GildardoRestrepo/greenhouse_Mata_freeRTOS/docs/arquitectura.md

---
type: arquitectura
created: 2026-11-08
estado: borrador — fuente de verdad del diseño de software
---
# Arquitectura de software — Mata

> [!resumen]
> 5 tareas de aplicación (CMSIS-RTOS v2 sobre FreeRTOS), 5 niveles de prioridad. La tarea **Control** es la única dueña de la máquina de estados y recibe *todo* por una sola cola de eventos. **Actuadores** recibe órdenes por notificación de tarea y corta la bomba por su cuenta aunque Control falle. El bus I²C se protege con un mutex; la UART tiene un único dueño (Logger), así que no lo necesita.

> [!nota] Bomba simulada (2026-11-10)
> Por presupuesto no hay bomba real: en **PC6 va un LED indicador** (con 220 Ω) que ocupa su lugar. En este documento "bomba" significa ese LED. El software no cambia: mismos nombres (`CMD_PUMP_PULSE`, `PUMP_PULSE_MS`, `EV_PUMP_DONE`), mismo pin y mismo pulso con tiempo máximo. El sensor de suelo es el resistivo **YL-69 + YL-38** (salida AO). Ver [[bom]].

---

## 1. Diagrama de bloques

```mermaid
flowchart LR
  subgraph Entradas
    SOIL[Sensor suelo YL-69<br/>ADC PC0]
    LDR[LDR<br/>ADC PC1]
    AHT[HTU21<br/>I2C1 0x40]
    BTN[K0 / K1 / K_UP<br/>EXTI]
  end
  subgraph STM32F407 + FreeRTOS
    SEN[tSensors]
    CTL[tControl]
    ACT[tActuators]
    DSP[tDisplay]
    LOG[tLogger]
  end
  subgraph Salidas
    PUMP[LED de riego<br/>PC6, bomba simulada]
    RGB[LED RGB<br/>TIM4 PWM]
    BUZ[Buzzer<br/>PC7 activo en alto]
    OLED[OLED<br/>I2C1]
    UART[USART1 → PC]
  end
  SOIL --> SEN
  LDR --> SEN
  AHT --> SEN
  BTN -- ISR --> CTL
  SEN -- qEvents --> CTL
  CTL -- notificación --> ACT
  ACT -- qEvents --> CTL
  ACT --> PUMP & RGB & BUZ
  DSP --> OLED
  CTL -. snapshot + mtxData .-> DSP
  CTL -- qLog --> LOG
  LOG --> UART
```

---

## 2. Tareas

| Tarea | Responsabilidad | Prioridad (CMSIS) | Activación | Pila (palabras) | Recursos compartidos |
|---|---|---|---|---|---|
| `tActuators` | Encender/apagar bomba con **tiempo máximo**; patrones de buzzer; color del LED RGB según estado | `osPriorityHigh` | Evento: notificación desde `tControl`. Timeout de la espera = fin del pulso de riego | 256 | GPIO PC6/PC7, TIM4 (solo ella) |
| `tControl` | Máquina de estados, umbrales con histéresis, detección de errores, decide riego | `osPriorityAboveNormal` | Evento: `qEvents` (lecturas, botones, fin de riego). Timeout 1 s para detectar sensores mudos | 256 | escribe `g_snapshot` (mtxData) |
| `tSensors` | Leer ADC (suelo, LDR) con promedio, leer HTU21 (con CRC), validar rangos | `osPriorityNormal` | Periódica **500 ms** (`osDelayUntil`); HTU21 cada 4 ciclos (2 s) | 256 | I2C1 (mtxI2C) |
| `tDisplay` | Dibujar pantallas en la OLED | `osPriorityBelowNormal` | Periódica **250 ms** | 384 | I2C1 (mtxI2C), lee `g_snapshot` (mtxData) |
| `tLogger` | Único escritor de la UART: mensajes y telemetría | `osPriorityLow` | Evento: `qLog` | 384 | USART1 (exclusiva) |

**5 niveles distintos** (High > AboveNormal > Normal > BelowNormal > Low); el mínimo exigido es 3.

### Justificación de prioridades (urgencia ↔ consecuencia de llegar tarde)
- **tActuators — la más alta.** Con una bomba real, apagar tarde inunda la matera; el LED de riego la representa y se mantiene la misma exigencia de tiempo. Su trabajo es corto (cambiar un pin), así que no roba CPU. Además corta la bomba por *timeout propio*: aunque Control se cuelgue, la bomba no queda encendida.
- **tControl — alta.** Debe reaccionar a botones y a lecturas en < 50 ms para que la interfaz se sienta inmediata y para mandar el apagado a tiempo. Trabajo acotado (una transición por evento).
- **tSensors — media.** La humedad del suelo cambia en minutos; un retraso de decenas de ms es irrelevante, pero el periodo debe ser estable para promediar bien.
- **tDisplay — baja.** Solo estética; si refresca 100 ms tarde nadie lo nota. Es la tarea más larga (≈25 ms de I²C por cuadro), por eso no debe bloquear a las demás.
- **tLogger — la más baja.** La telemetría puede salir tarde sin consecuencias; la cola absorbe ráfagas.

### Verificación de pila
- `configCHECK_FOR_STACK_OVERFLOW = 2` + `vApplicationStackOverflowHook()` → `act_fatal_stack_overflow()`: bomba y buzzer apagados, LED rojo fijo y el sistema se detiene (sin mensaje: en ese punto la UART ya no es confiable).
- Cada tarea reporta `uxTaskGetStackHighWaterMark(NULL)` al logger cada 10 s (comando o modo debug). Criterio: **≥ 25 % libre** después de la prueba de 5 min. Documentar los valores medidos en la tabla final.
- Regla: nada de buffers grandes en pila (framebuffer OLED de 1 KB es `static` global).

---

## 3. Comunicación y sincronización

| Objeto | Tipo | Productores → Consumidor | Dato | Por qué este mecanismo |
|---|---|---|---|---|
| `qEvents` | Cola, 8 × `app_event_t` | tSensors, tActuators, ISR botones → **tControl** | lectura nueva, botón, fin de riego, fallo | Varios productores, un consumidor; serializa todo lo que cambia el estado → la máquina de estados no necesita locks. ISR-safe (`osMessageQueuePut` con timeout 0). |
| notificación de `tActuators` | Thread flags de CMSIS-RTOS v2 (= task notification de FreeRTOS; un bit por comando) | **tControl** → tActuators | `CMD_PUMP_PULSE`, `CMD_PUMP_STOP`, `CMD_BEEP`, `CMD_LED_STATE` | Un solo consumidor conocido; más rápida y liviana que una cola. El timeout de la espera sirve como temporizador del pulso. |
| `qLog` | Cola, 16 × `log_msg_t` (64 B) | todas → **tLogger** | texto con timestamp | Desacopla: nadie se bloquea esperando la UART. |
| `mtxI2C` | Mutex (herencia de prioridad) | tSensors, tDisplay | acceso al bus I2C1 | Dos tareas usan el mismo bus; una transacción a medias corrompe ambas. Mutex (no semáforo) por la herencia de prioridad. |
| `mtxData` | Mutex | tControl (escribe), tDisplay y tLogger (leen) | `g_snapshot` (estado + últimas lecturas) | Estructura de varios campos: sin protección la pantalla podría mostrar mezcla de lecturas viejas y nuevas. |
| sem. DMA UART | Notificación desde `HAL_UART_TxCpltCallback` | ISR → tLogger | fin de transmisión | El logger se **bloquea** mientras el DMA envía (no hay espera activa). |

```mermaid
sequenceDiagram
  participant ISR as ISR EXTI
  participant SEN as tSensors (Normal)
  participant CTL as tControl (AboveNormal)
  participant ACT as tActuators (High)
  participant LOG as tLogger (Low)
  SEN->>CTL: qEvents: EV_READING (suelo 12 %)
  CTL->>ACT: notify CMD_PUMP_PULSE
  CTL->>LOG: qLog "MONITOREO→RIEGO"
  Note over ACT: bomba ON, espera notificación<br/>con timeout 1 s
  ACT->>CTL: qEvents: EV_PUMP_DONE (timeout)
  ISR->>CTL: qEvents: EV_BTN_K1 (manual)
```

### Tipos compartidos (`App/Inc/app_types.h`)
```c
typedef enum { ST_INIT, ST_MONITOR, ST_IRRIGATE, ST_MANUAL, ST_ALARM } sys_state_t;

typedef enum {
  EV_READING, EV_SENSOR_FAULT, EV_PUMP_DONE,
  EV_BTN_K0, EV_BTN_K1, EV_BTN_KUP, EV_BTN_KUP_LONG
} event_type_t;

typedef struct {
  int16_t  soil_pct;      /* 0..100, -1 = inválido */
  int16_t  light_pct;     /* 0..100 */
  int16_t  temp_cC;       /* centésimas de °C (evita printf de float) */
  int16_t  hum_cPct;      /* centésimas de %HR */
  uint8_t  valid_mask;    /* bit0 suelo, bit1 luz, bit2 aire */
} readings_t;

typedef struct {
  event_type_t type;
  uint32_t     tick;      /* osKernelGetTickCount() al crear el evento */
  union { readings_t r; uint8_t fault_code; } data;
} app_event_t;

/* Causa de un fallo: en EV_SENSOR_FAULT y en el snapshot (la OLED la muestra). */
typedef enum {
  FAULT_NONE, FAULT_SOIL, FAULT_AIR, FAULT_ADC,       /* los genera tSensors */
  FAULT_TIMEOUT, FAULT_NO_WATER, FAULT_OVERTEMP       /* los decide tControl */
} fault_code_t;

/* g_snapshot: lo escribe tControl (shared_set), lo leen tDisplay y tLogger (shared_get). */
typedef struct {
  sys_state_t state;
  readings_t  r;
  uint8_t     fault_code;  /* causa de la alarma */
  uint8_t     screen;      /* tControl lo incrementa con K0; tDisplay usa screen % 3 */
  uint32_t    tick;        /* última actualización */
} snapshot_t;
```
- `valid_mask`: `READ_VALID_SOIL` (bit0), `READ_VALID_LIGHT` (bit1), `READ_VALID_AIR` (bit2).
- **Contrato de tSensors:** envía `EV_READING` en **cada** ciclo (500 ms) con las lecturas y su `valid_mask` (sirve de "sigo viva"); el aire se mide cada 2 s, **después de enviar el evento** (la medida del HTU21 tarda ≈ 75 ms y no debe retrasarlo), así que el dato nuevo viaja en el evento del ciclo siguiente; entre medidas se repite el último valor bueno. `EV_SENSOR_FAULT` se envía **una sola vez** cuando el fallo se confirma (suelo: 1 ciclo; aire: 3 lecturas = 6 s; ADC: 3 ciclos). Para saber si la causa ya se resolvió, tControl mira el `valid_mask` de las lecturas siguientes.
Cambiar estos tipos = avisar a la pareja (ver [[CLAUDE]]).

---

## 4. Máquina de estados (tControl)

```mermaid
stateDiagram-v2
  [*] --> INIT
  INIT --> MONITOREO: autotest OK (I2C responde, ADC en rango)
  INIT --> ALARMA: autotest falla
  MONITOREO --> RIEGO: suelo < UMBRAL_SECO
  RIEGO --> RIEGO: pulso + espera de absorción, suelo aún seco
  RIEGO --> MONITOREO: suelo ≥ UMBRAL_HUMEDO
  RIEGO --> ALARMA: N pulsos sin que suba la humedad (riego sin efecto)
  MONITOREO --> MANUAL: K_UP
  MANUAL --> MONITOREO: K_UP
  MANUAL --> MANUAL: K1 = pulso de riego manual
  MONITOREO --> ALARMA: sensor desconectado / timeout / temp > máx
  RIEGO --> ALARMA: fallo de sensor
  ALARMA --> MONITOREO: K1 (reconocer) y causa resuelta
```

| Estado | LED RGB | Buzzer | Bomba (LED PC6) |
|---|---|---|---|
| INIT | blanco | 1 bip | off |
| MONITOREO | verde | — | off |
| RIEGO | azul (respira con PWM) | — | pulsos |
| MANUAL | ámbar | — | solo con K1 |
| ALARMA | rojo parpadeando | bip cada 2 s | **off forzado** |

### Parámetros (en `App/Inc/app_config.h`, valores de demo)
| Parámetro | Demo | Real | Nota |
|---|---|---|---|
| `SOIL_DRY_PCT` | 15 % | 15 % | entra a RIEGO (el jade se riega con el sustrato casi seco) |
| `SOIL_WET_PCT` | 35 % | 35 % | sale de RIEGO (histéresis; más alto encharca una suculenta) |
| `PUMP_PULSE_MS` | 1 000 | 1 000 | tiempo máximo del pulso de riego (LED de PC6 encendido; serían ≈30 ml con la bomba real) |
| `SOAK_MS` | 15 000 | 30 min | espera para que el agua se absorba; en la demo es el tiempo que hay para mojar la sonda a mano |
| `MAX_PULSES_NO_RISE` | 3 | 3 | → alarma "sin agua" |
| `SENSOR_TIMEOUT_MS` | 3 000 | 3 000 | sin lecturas → alarma |
| `TEMP_MAX_cC` | 3500 | 3500 | sobrecalentamiento |

### Errores previsibles (requisito 4.7)
| Error | Detección | Reacción |
|---|---|---|
| Cable AO del sensor de suelo suelto | ADC < `SOIL_RAW_MIN` (pull-down 100 kΩ lleva el pin a 0) | ALARMA, bomba bloqueada |
| Sonda YL-69 suelta del módulo YL-38 | No se distingue de "suelo seco": AO sube al máximo | entra a RIEGO y, tras N pulsos sin subir la humedad, ALARMA "sin agua" |
| HTU21 no responde o CRC inválido | HAL_I2C ≠ HAL_OK o CRC-8 incorrecto, 3 veces seguidas | ALARMA "aire" (decidido el 2026-11-10: también bloquea el riego, para que sea observable) |
| tSensors deja de reportar | `qEvents` vacía > `SENSOR_TIMEOUT_MS` (timeout de la espera) | ALARMA "timeout" |
| Riego sin efecto (con la bomba simulada: nadie mojó la sonda) | N pulsos sin subir la humedad | ALARMA "sin agua" |
| Bomba encendida demasiado | timeout propio en tActuators | se apaga sí o sí |
| Botón con rebote | antirrebote por tiempo en ISR (ignora < 50 ms); la pulsación larga (`EV_BTN_KUP_LONG`) quedó sin usar | — |
| Lectura fuera de rango físico | temp < -10 / > 60 °C, HR > 100 % | se descarta, cuenta como fallo |

---

## 5. Demostración de preempción (sección 6.4)

**Escenario:** `tDisplay` (BelowNormal) está enviando un cuadro completo a la OLED (~25 ms de I²C, trabajo no instantáneo). Se presiona K1 → la ISR pone `EV_BTN_K1` en `qEvents` → `tControl` (AboveNormal) pasa de **bloqueada** a **lista**, y como tiene más prioridad que la que se ejecuta, el scheduler la pone a **ejecutar** inmediatamente (en la salida de la ISR, `portYIELD_FROM_ISR`). Control notifica a `tActuators` (High), que a su vez desaloja a Control, enciende la bomba y se bloquea. Luego Control termina y solo entonces Display continúa su cuadro.

**Evidencia:**
1. **UART (implementada):** cada evento lleva `tick`. Con `DISPLAY_TRACE_FRAMES = 1` el log muestra `DSP frame start t=…`, `CTL EV_BTN_K1 t_isr=… t=…`, `ACT bomba ON t=…`, `DSP frame end t=…`, con los tiempos de Control/Actuators **dentro** del intervalo de Display. Necesita el adaptador USB-TTL, que al 2026-11-11 no se ha conseguido; sin él, los mismos valores se leen en el depurador (`s_tx_buf` y `g_snapshot` en *Expressions*).
2. **Analizador lógico (opcional, no implementado):** PE7–PE11 están configurados como salidas para trazas, pero no se escribieron los hooks `traceTASK_SWITCHED_IN/OUT` y no hay analizador.

> **Estados de tarea:** *ejecutándose* = la que tiene la CPU; *lista* = podría correr pero hay otra de igual o mayor prioridad corriendo; *bloqueada* = esperando un retardo (`osDelayUntil`) o un evento (cola, notificación, mutex) → **no consume CPU**. Entre tareas listas de igual prioridad hay *round-robin* por tick (1 ms); con distinta prioridad siempre corre la de mayor.

---

## 6. Organización del código

```
firmware/brote/                 ← proyecto STM32CubeIDE
├── brote.ioc                   ← CubeMX: reloj, pines, periféricos, tareas, colas, mutex
├── Core/                       ← generado por CubeMX; solo tocar dentro de USER CODE
│   ├── Inc/ FreeRTOSConfig.h, main.h, ...
│   └── Src/ main.c, freertos.c, stm32f4xx_it.c, ...
├── App/                        ← NUESTRO código (CubeMX nunca lo toca)
│   ├── Inc/ app_config.h, app_types.h, app_shared.h, task_*.h, drv_*.h
│   └── Src/
│       ├── task_sensors.c  task_control.c  task_actuators.c  task_display.c  task_logger.c
│       ├── state_machine.c       ← lógica pura de transiciones (sin HAL → fácil de probar)
│       ├── drv_htu21.c  drv_ssd1306.c  font_6x8.c
│       ├── drv_analog.c          ← ADC suelo + LDR, calibración
│       └── drv_outputs.c         ← LED de riego (bomba), buzzer, RGB
├── Drivers/  Middlewares/      ← HAL y FreeRTOS de ST, no se editan
```

- Las tareas se declaran en CubeMX con **"Code Generation Option: As weak"**; CubeMX genera `__weak void StartSensorsTask(void *argument)` en `freertos.c` y nosotros damos la definición real en `App/Src/task_sensors.c`. Así el `.ioc` documenta prioridades/pilas y el código vive fuera de lo generado.
- **Lectura del HTU21 (módulo GY-21, 0x40):** temperatura y humedad son **dos medidas separadas**, cada una con el mismo ciclo: comando *no-hold master* (`0xF3` temperatura, `0xF5` humedad) → **soltar `mtxI2C`** → `osDelay` (55 ms para temperatura, 20 ms para humedad; la conversión dura 50 y 16 ms como máximo) → tomar mutex → leer 3 bytes (MSB, LSB, CRC) → soltar. Así no se duerme con el mutex tomado y la OLED puede usar el bus durante la conversión. CRC-8 polinomio 0x31, **init 0x00**. Antes de convertir se enmascaran los 2 bits de estado (`raw & 0xFFFC`). Conversión en punto fijo: `temp_cC = -4685 + 17572*raw/65536`, `hum_cPct = -600 + 12500*raw/65536` (aritmética de 32 bits; la humedad se satura a 0..100 %).
- **Refresco de la OLED:** el framebuffer (1 KB, `static`) se envía en 8 páginas de 128 bytes; `mtxI2C` se toma y se suelta en **cada página**, así tSensors espera el bus ≈ 3 ms como máximo en vez de los ≈ 24 ms del cuadro completo.
- Capas: `task_*` (lógica RTOS) → `drv_*` (usa HAL) → HAL. Las tareas no llaman HAL directamente salvo casos triviales.
- **Bases de tiempo** (todas salen del cristal HSE de 8 MHz, PLL → 168 MHz):
  - **SysTick**: tick de FreeRTOS cada 1 ms (`configTICK_RATE_HZ = 1000`). De él salen `osDelay`, `osDelayUntil` y todos los timeouts de colas, flags y mutex.
  - **TIM6**: tick de la HAL (`HAL_GetTick`), también cada 1 ms. Separado de SysTick para que la HAL y el scheduler no compitan.
  - **TIM4**: no mide tiempo; genera el PWM de 1 kHz del LED RGB.
  - No se usan *software timers* de FreeRTOS: los tiempos del riego, el bip y el parpadeo salen del timeout de la espera de cada tarea.

---

## 7. Configuración CubeMX (checklist)

- **RCC:** HSE = Crystal (8 MHz), LSE opcional. **Clock:** PLL → SYSCLK 168 MHz, AHB 168, APB1 42, APB2 84.
- **SYS:** Debug = **Serial Wire** (si no, se pierde el ST-Link). Timebase Source = **TIM6** (SysTick queda para FreeRTOS). ⚠️ CubeMX 6.18.1 no generó `TIM6_DAC_IRQHandler`: está escrito a mano en `Core/Src/stm32f4xx_it.c`, `USER CODE BEGIN 1` (sin él, el primer tick de `HAL_Init()` cae en `Default_Handler`). Si una regeneración lo crea, el enlazador avisa con *multiple definition* y se borra la copia.
- **FREERTOS:** CMSIS_V2. `USE_NEWLIB_REENTRANT = Enabled`. Heap_4, `TOTAL_HEAP_SIZE = 32768`. `CHECK_FOR_STACK_OVERFLOW = Option2`. `USE_TRACE_FACILITY = 1`, `INCLUDE_uxTaskGetStackHighWaterMark = 1`. Tareas, colas y mutex de las tablas anteriores (tareas *As weak*).
- **ADC1:** IN10 (PC0), IN11 (PC1), 12 bits, sample time **480 ciclos** (fuentes de alta impedancia), conversión simple por software.
- **I2C1:** PB6/PB7, Fast Mode 400 kHz.
- **TIM4:** CH1–CH3 PWM en PD12–PD14, ~1 kHz, ARR = 999.
- **USART1:** PA9/PA10 115200 8N1, **DMA TX** (DMA2 Stream7), interrupción global habilitada.
- **GPIO:** PC6 (`PUMP_LED`, inicia en bajo) y PC7 (`BUZZER`, activo en alto: debe iniciar en **bajo**; hoy el `.ioc` lo inicia en alto y suena un instante al arrancar, pendiente) como salidas; PE7–PE11 salidas reservadas para trazas (sin uso); PA6/PA7 salida (inician en alto = LED apagado); PE3/PE4 EXTI falling + pull-up (`BTN_K1`, `BTN_K0`); PA0 EXTI rising + pull-down (`BTN_KUP`).
- **NVIC:** EXTI0, EXTI3 y EXTI4 en prioridad 6; USART1 y DMA2 Stream7 en 5. Todas **≥ 5** (numérica) y marcadas "Uses FreeRTOS functions".
- **Project Manager:** proyecto `brote` en `firmware/brote/` (`brote.ioc` junto a `App/`). "Generate peripheral initialization as a pair of .c/.h files" = sí. Toolchain STM32CubeIDE. `App/Inc` y `App/` están en las rutas de include y de fuentes del `.cproject`.

---

## Enlaces
- [[propuesta]] · [[enunciado]] · [[CLAUDE]]
