GildardoRestrepo/greenhouse_Mata_freeRTOS/docs/bitacora.md

---
type: bitacora
created: 2026-11-08
---
# Bitácora del equipo

Entradas nuevas **arriba**. Formato: fecha · quién · hecho · pendiente · decisiones · problemas.

---

## 2026-11-11 · ESTEVAN (+ Claude) — repaso de consistencia de la documentación
- **Hecho:** docs alineados con el código y la placa. Buzzer **activo en alto** también en el diagrama de [[arquitectura]]; hook de desborde de pila descrito como está (LED rojo fijo, sin mensaje); fallo del aire bloquea el riego (decisión del 2026-11-10); pulsación larga de K_UP sin uso; evidencia de preempción por UART o depurador (los pines de traza PE7–PE11 quedan reservados, sin hooks ni analizador); bases de tiempo (SysTick, TIM6, TIM4) en §6; checklist de CubeMX al día (`TIM6_DAC_IRQHandler` escrito a mano, prioridades NVIC reales, `brote.ioc` junto a `App/`). P04 corregida a pulsos cada ≈ 16 s y P10 sin analizador. `bom.md`: USB-TTL aún no conseguido. `README`: BOM, cableado y estado actual.
- **Pendiente:** sin cambios respecto a la entrada de abajo (PC7 en bajo en el `.ioc`, USB-TTL, P07, P10–P12).

## 2026-11-11 · MARCO y ESTEVAN (+ Claude) — primera prueba en la placa, calibración y buzzer
- **Hecho:** proyecto corriendo en la placa con todo conectado. Calibración medida con el depurador (breakpoint en la línea `SEN` de `task_sensors.c`): suelo aire = 3604, agua = 1187; LDR tapada = 987, linterna = 3531. Valores en `app_config.h` (**archivo compartido**). Probados en la placa riego automático (P04) y alarma "sin agua" (P06).
- **INTERFAZ:** el buzzer es **activo en alto**, no en bajo. `out_buzzer()` en `drv_outputs.c`: sonar = `GPIO_PIN_SET`. Corregidos `propuesta.md`, `cableado.md`, `bom.md` y el `README`.
- **Problemas (sirven para "problema técnico resuelto"):**
  - *Buzzer sonando siempre.* VCC ya estaba a 3V3. Se soltó el cable de señal y se llevó a 3V3 (seguía sonando) y a GND (se calló): el módulo es de disparo en alto. Solución: invertir el nivel en `out_buzzer()`.
  - *"`osKernelStart()` retorna".* Era falso: se estaba depurando otro proyecto (`LASD9`), porque el botón de debug relanza la última configuración. Pista: los números de línea de `main.c` en la consola no coincidían con los de `brote`. El heap no era el problema: se usan ≈ 8,7 KB de 32 KB, e Idle y Timers son estáticos.
- **Decisiones:** sin adaptador USB-TTL, las lecturas se toman con el depurador (`g_snapshot` y `s_tx_buf` en la vista Expressions).
- **Pendiente:**
  - Estevan (CubeMX): PC7 *GPIO output level* = **Low**. Hoy el `.ioc` lo inicia en alto y el buzzer suena un instante en cada arranque.
  - Conseguir un USB-TTL (o un Arduino como puente) para P01, P19 y P26; sin él no se puede mostrar la telemetría por UART.
  - Pruebas que faltan: sensor de suelo desconectado (P07), preempción (P10), estabilidad y pilas (P11, P12).

## 2026-11-10 · MARCO (+ Claude) — arreglo de P19 y diagrama de cableado (rama `fix/p19-y-cableado`)
- **PR #4 de Estevan** (proyecto base + control, actuadores y logger): revisados los puntos de integración con sensores y pantalla y **aprobado**. De acuerdo con que el fallo de aire pase a ALARMA.
- **Problema (lo detectó Estevan al revisar el PR #3):** con el HTU21, en los ciclos de aire `EV_READING` salía ≈ 75 ms después de despertar, porque tSensors medía el aire antes de enviar. P19 (un evento cada 500 ms ± 1 ms) habría fallado uno de cada cuatro ciclos.
- **Solución:** `task_sensors.c` ahora envía `EV_READING` justo después de los analógicos y mide el HTU21 **después**. El dato nuevo del aire viaja en el evento del ciclo siguiente (500 ms más tarde, irrelevante para temperatura y humedad).
- **INTERFAZ (contrato de tSensors, [[arquitectura]] §3):** no cambian tipos ni nombres. Cambia el orden: `EV_SENSOR_FAULT` con `FAULT_AIR` puede llegar hasta 500 ms **antes** que el primer `EV_READING` con el bit de aire apagado, y el primer evento tras el arranque llega sin dato de aire.
- **Hecho además:** `docs/cableado.md` (diagrama y lista de conexiones para armar, a partir de [[propuesta]] §3) y P19 reescrita.
- **Pendiente:** compilar (el cambio no se ha compilado: este PC no tiene toolchain) y ejecutar P19 y P20 en la placa.

## 2026-11-10 · ESTEVAN (+ Claude) — revisión de PRs y módulos de control (rama `feat/control-actuadores`)
- **PRs de Marco:** #2 (BOM reducido) y #3 (HTU21) revisados, aprobados y mergeados en `main`. Observaciones que quedaron en los PR: P19 fallará tal como está escrita (en los ciclos de aire `EV_READING` sale ≈ 75 ms después de despertar) y, al calibrar la YL-69 (P16), el crudo "mojado" debe quedar holgado sobre `SOIL_RAW_MIN`.
- **Hecho (todo en `firmware/brote/App`):**
  - `task_logger` (`StartLoggerTask`, `log_printf`, `log_msg_t`): formatea en la pila de quien llama, encola en `qLog` con timeout 0 (cuenta los perdidos) y envía por **DMA**; se bloquea en un thread flag que pone `HAL_UART_TxCpltCallback`.
  - `state_machine` (pura, sin HAL ni RTOS): `sm_init` / `sm_step` → nuevo estado + máscara de acciones. Autotest de INIT = primera lectura con suelo válido.
  - `task_control` (`StartControlTask`): consume `qEvents`, alimenta la máquina, publica `g_snapshot`, manda órdenes a tActuators y detecta el timeout de sensores con el timeout de la cola. Aquí está `HAL_GPIO_EXTI_Callback` (antirrebote 50 ms, `osMessageQueuePut` con timeout 0).
  - `task_actuators` (`StartActuatorsTask`, `act_send`): órdenes como thread flags (`CMD_PUMP_PULSE/STOP/BEEP/LED_STATE`); corta el pulso por su propio timeout; RGB por estado (blanco, verde, azul que respira, ámbar, rojo parpadeando) y bip cada 2 s en ALARMA.
  - `drv_outputs`: LED de riego PC6, buzzer PC7 (activo en bajo), RGB por TIM4 CH1–CH3.
  - **Compila sin errores ni warnings** (solo `-fsyntax-only`, con el ARM GCC de CubeIDE, la HAL y FreeRTOS 10.3.1 del repositorio de Cube y cabeceras simuladas para `main.h`/`i2c.h`/`adc.h`/`tim.h`/`usart.h`). Incluye el código de Marco. Falta el enlazado real con el proyecto generado.
- **INTERFAZ:**
  - `app_config.h`: **`TASK_ACTUATORS_STACK_WORDS` 128 → 256** (log_printf usa vsnprintf en la pila de quien llama; actualizado en [[arquitectura]] §2). Constantes nuevas: `TEMP_HYST_cC`, `SOIL_RISE_MIN_PCT`, `ACT_*`, `ALARM_*`, `RGB_*`, `LOG_TX_TIMEOUT_MS`. Se corrigió el comentario "capacitivo" de la calibración de suelo.
  - En el `.ioc`: cola `qLog` con Item Size `log_msg_t`; handles que usa el código: `qLogHandle`, `tLoggerHandle`, `tActuatorsHandle` (además de los de Marco).
  - En `freertos.c` (USER CODE): `#include "app_types.h"`, `#include "task_logger.h"`, `#include "task_actuators.h"`, y en el cuerpo de `vApplicationStackOverflowHook` la línea `act_fatal_stack_overflow();`.
- **Decisiones:**
  - Fallo del aire → ALARMA (no "seguir regando"): así P08 es observable y explicable.
  - Riego sin efecto: se cuenta un pulso "sin subida" si tras `PUMP_PULSE_MS + SOAK_MS` la humedad no subió `SOIL_RISE_MIN_PCT`; al 3.º → ALARMA "sin agua".
  - Para reconocer una alarma con K1 la causa debe estar resuelta (la de "sin agua" siempre se puede reconocer).
  - `EV_BTN_KUP_LONG` no se usa por ahora (PA0 solo con flanco de subida).
- **Pendiente:** crear el `.ioc` y el proyecto base; compilar y enlazar; pruebas P26–P33; hooks de traza `traceTASK_SWITCHED_IN/OUT` para el analizador (opcional, la evidencia por UART ya está en P30).
- **Problemas:** —

## 2026-11-10 · MARCO (+ Claude) — el sensor de aire pasa de SHT30 a HTU21 (GY-21), rama `feat/htu21`
- **Motivo:** no había SHT30 en la tienda; se compró el **HTU21D en módulo GY-21**.
- **INTERFAZ (cambian el archivo y las funciones del driver):** `drv_sht30.*` → **`drv_htu21.*`**, prefijo `sht30_` → **`htu21_`**. Ya no existe `sht30_read(&t, &h)`: ahora son `htu21_read_temp(&temp_cC)` y `htu21_read_hum(&hum_cPct)` por separado, más `htu21_init()`. Estados `HTU21_OK / ERR_MUTEX / ERR_BUS / ERR_CRC`. Gildardo: si `task_control.c`, el autotest de INIT o algún documento tuyo nombran `sht30_*` o la dirección 0x44, hay que cambiarlos.
- **INTERFAZ (`app_config.h`):** `SHT30_EVERY_N_CYCLES` → `HTU21_EVERY_N_CYCLES`; `SHT30_MEAS_DELAY_MS` → `HTU21_TEMP_DELAY_MS` (55) y `HTU21_HUM_DELAY_MS` (20); `SHT30_I2C_TIMEOUT_MS` → `HTU21_I2C_TIMEOUT_MS`. Se añadió `#include <stdint.h>` (nota de Gildardo en el PR #1).
- **No cambia:** bus I2C1 (PB6/PB7) y `mtxI2C`, `readings_t` (`temp_cC`, `hum_cPct`), `FAULT_AIR`, el contrato de eventos de tSensors y el periodo de 2 s del aire.
- **Hecho:**
  - `drv_htu21`: dirección **0x40**; comandos no-hold `0xF3` (temperatura) y `0xF5` (humedad); cada medida hace comando → soltar `mtxI2C` → `osDelay` → tomar → leer 3 bytes; CRC-8 poli 0x31 con **init 0x00**; máscara `raw & 0xFFFC`; `temp_cC = -4685 + 17572*raw/65536`, `hum_cPct = -600 + 12500*raw/65536`.
  - `task_sensors.c`: dos lecturas seguidas (≈ 75 ms en total, bloqueada sin espera activa); el dato de aire solo vale si las dos salen bien.
  - `propuesta.md`, `arquitectura.md` (§1, §2, §4, §6), `bom.md`, `pruebas.md` (P02, P08, P13, P14, P20, P24), `README.md` y `CLAUDE.md` al día.
- **Decisiones:**
  - Esperas de **55 y 20 ms** en vez de los 50 y 16 ms nominales: `osDelay(n)` puede durar hasta un tick menos que `n`, y leer antes de tiempo da NACK.
  - La humedad se **satura a 0..100 %** en el driver: la fórmula da de −6 % a 119 % y, sin recortar, un invernadero cerrado cerca de la saturación daría lecturas "fuera de rango" y falsas `FAULT_AIR`.
- **Verificado (solo lógica, en Python):** CRC de los ejemplos de la hoja de datos (`0xDC`→`0x79`, `0x683A`→`0x7C`, `0x4E85`→`0x6B`) y conversiones (`0x683A`→24,68 °C, `0x4E85`→32,33 %). **Sigue sin compilar**: no hay proyecto base.
- **Pendiente:** probar P13/P14/P20/P24 con el módulo real. La compra completa costó **$59.160** (anotado en [[bom]]; no se desglosó el precio del GY-21).
- **Problemas:** el SHT30 no se consiguió (sirve para "problema técnico resuelto": el cambio quedó aislado en el driver y dos constantes, sin tocar tipos ni tareas vecinas).

## 2026-11-10 · MARCO (+ Claude) — BOM reducido: sensor resistivo y bomba simulada con LED
- **Motivo:** presupuesto ajustado. La lista pasa de ≈ $120.000 a ≈ $47.150 ([[bom]]).
- **INTERFAZ (cableado; afecta `task_actuators` / `drv_outputs` de Gildardo):** la **bomba real se reemplaza por un LED indicador en PC6** (LED rojo + 220 Ω a GND, activo en alto). Gildardo **ya aprobó** este cambio. Salen el TIP122, el 1N4007, el condensador, la manguera y la fuente de 5 V. El firmware no cambia: mismo pin, mismos nombres (`CMD_PUMP_PULSE`, `PUMP_PULSE_MS`, `EV_PUMP_DONE`) y mismo pulso con tiempo máximo.
- **INTERFAZ (sensor de suelo; afecta `drv_analog` de Marco):** el capacitivo se reemplaza por el **resistivo YL-69 + módulo YL-38**, salida **AO** a PC0, alimentado a 3,3 V. Lee al revés (seco ≈ máximo del ADC, mojado = bajo); `analog_raw_to_pct()` ya admite ese sentido, pero `SOIL_RAW_DRY`, `SOIL_RAW_WET` y `SOIL_RAW_MIN` de `app_config.h` siguen con valores pensados para el capacitivo y hay que medirlos (P16).
- **Otros cambios:** LDR de 12 mm → 5 mm; protoboard fuera de la lista (ya la tenemos).
- **Consecuencias para la demo:**
  - Sin bomba el suelo no se moja solo: el ciclo de riego se cierra mojando la sonda a mano. Si nadie la moja, tras 3 pulsos hay ALARMA "sin agua" (P06 se reescribió así).
  - Si la sonda YL-69 se suelta del módulo YL-38, la lectura no se distingue de "suelo seco"; solo se detecta el cable AO suelto (pull-down de 100 kΩ). Queda en la tabla de errores de [[arquitectura]] §4.
- **Hecho:** `bom.md` reescrito; `propuesta.md` §1–§4, `arquitectura.md` (nota inicial, diagrama, §2, §4, §6) y `pruebas.md` (P04, P06, P16) puestos al día. `CLAUDE.md` en commit aparte (regla de cargas).
- **Pendiente:** actualizar los comentarios de `app_config.h` y `drv_analog.h` que todavía dicen "capacitivo" (código, va en otra rama); calibrar con el YL-69.
- **Problemas:** —

## 2026-11-09 · MARCO (+ Claude) — drivers y tareas de Marco adelantados (rama `feat/drivers-sensores`)
Todo está en `firmware/brote/App/{Inc,Src}`. **Nada se ha compilado**: no existe todavía el proyecto base ni hay toolchain en el PC de Marco. Solo se verificó en Python la lógica del CRC, las conversiones del SHT30 y el dibujo de la fuente.

- **Hecho:**
  - `drv_sht30`: `sht30_init()` (ACK en 0x44) y `sht30_read(&temp_cC, &hum_cPct)` (0x2400 → soltar `mtxI2C` → `osDelay(20)` → leer 6 bytes → CRC-8 → punto fijo).
  - `drv_ssd1306` + `font_6x8`: framebuffer `static` de 1 KB, `init`, `clear`, `update`, píxel, rectángulos, texto con escala y barras.
  - `drv_analog`: suelo (PC0/IN10) y LDR (PC1/IN11), promedio de 8 muestras, calibración lineal desde `app_config.h`, suelo desconectado si crudo < `SOIL_RAW_MIN`.
  - `task_sensors` (`StartSensorsTask`): 500 ms con `osDelayUntil`, SHT30 cada 4 ciclos, validación de rango físico, `EV_READING` / `EV_SENSOR_FAULT` a `qEvents`.
  - `task_display` (`StartDisplayTask`): 250 ms, `shared_get()` + 3 pantallas (resumen, suelo en grande, diagnóstico), pantalla de INIT y de ALARMA parpadeante, reconexión en caliente de la OLED.
  - `docs/pruebas.md`: P13–P25 (una o más por módulo). `docs/arquitectura.md` §3 y §6 actualizados con lo de abajo.
- **INTERFAZ (archivos compartidos creados por Marco; Estevan, revisa):**
  - `app_types.h`: lo de [[arquitectura]] §3 tal cual, **más** `fault_code_t` (`FAULT_NONE/SOIL/AIR/ADC/TIMEOUT/NO_WATER/OVERTEMP`), los bits `READ_VALID_SOIL/LIGHT/AIR` y `snapshot_t { state, r, fault_code, screen, tick }`.
  - `app_config.h`: valores "Demo" de §4, periodos, tamaños de colas, prioridades/pilas (solo como referencia: mandan las del `.ioc`) y los parámetros de mis drivers.
  - `app_shared.h/.c`: `g_snapshot` + `shared_get()/shared_set()` con `mtxData`, y los `extern` de `qEventsHandle`, `mtxI2CHandle`, `mtxDataHandle`.
  - **Contrato de tSensors → tControl:** `EV_READING` en cada ciclo de 500 ms con `valid_mask`; `EV_SENSOR_FAULT` **una sola vez** al confirmarse el fallo. Para "causa resuelta" tControl mira el `valid_mask` de las lecturas siguientes.
  - **Lo que tDisplay espera de tControl:** que `shared_set()` mantenga `state`, `r`, `tick`, `fault_code` (causa de la alarma) y que incremente `screen` con K0.
- **Supuestos sobre el proyecto base (Estevan, confirmar al crear el `.ioc`; cada uno es un cambio de una línea si no coincide):**
  - Nombres en CubeMX: cola `qEvents`, mutex `mtxI2C` y `mtxData` → handles `qEventsHandle`, `mtxI2CHandle`, `mtxDataHandle`. Funciones de entrada `StartSensorsTask` y `StartDisplayTask`, *As weak*.
  - Periféricos generados como par `.c/.h`: `i2c.h` exporta `hi2c1`, `adc.h` exporta `hadc1`. ADC1 con una sola conversión por software (el driver cambia de canal).
  - `task_logger.h` declara `void log_printf(const char *fmt, ...);`.
  - Tick de 1 ms (`configTICK_RATE_HZ = 1000`).
- **Decisiones:**
  - La OLED se envía **página por página** soltando `mtxI2C` entre una y otra: tSensors espera el bus ≈ 3 ms como máximo, no los ≈ 24 ms del cuadro.
  - Si la OLED falla, tDisplay solo lo registra en el log y reintenta cada 2 s; **no** genera alarma (una pantalla dañada no debe parar el riego).
  - tDisplay arma los textos con un formateador entero propio (sin `snprintf`) para cuidar la pila.
  - El ADC se lee con `HAL_ADC_PollForConversion`: la conversión dura ≈ 25 µs, mucho menos que un tick, así que no hay forma útil de bloquearse (justificación en `drv_analog.c`).
- **Pendiente:** compilar e integrar cuando llegue el proyecto base; calibrar (`SOIL_RAW_*` y `LIGHT_RAW_*` son provisionales); ejecutar P13–P25; medir pilas (P25). Para la captura de preempción, poner `DISPLAY_TRACE_FRAMES = 1`; para la demo, `SENSORS_LOG_READINGS = 0` si el log estorba.
- **Problemas:** —

## 2026-11-08 · GILBERT (+ Claude) — BOM y cambio de sensor
- **INTERFAZ:** el AHT20 se reemplaza por un **SHT30** (I²C 0x44, CRC-8 por medida, mejor en ambiente húmedo). Driver `drv_sht30.c`, prefijo `sht30_` (antes `drv_aht20.c` / `aht20_`). Mismo bus I2C1 y mismo `mtxI2C`. Procedimiento de lectura en [[arquitectura]] §6.
- **INTERFAZ:** el buzzer es un **módulo con PNP integrado, activo en bajo**, alimentado a 3V3 y conectado directo a PC7 (sin 2N2222). En `drv_outputs.c`: sonar = `GPIO_PIN_RESET`, PC7 inicia en alto.
- **Hecho:** `bom.md` con links y precios (Ardobot), revisado. TIP120 agotado → **TIP122** (mismo circuito).
- **Pendiente:** confirmar que el SHT30 de Ardobot es módulo de 4 pines con pull-ups (la página no lo dice); conseguir manguera de silicona de 6 mm interior (no la vende Ardobot: acuario o ferretería).

## 2026-11-08 · GILBERT (+ Claude)
- **Hecho:** lectura del enunciado y del esquemático de la placa (STM32_F4VE). Propuesta (`propuesta.md`), arquitectura (`arquitectura.md`), `CLAUDE.md` y `.claude/settings.json`.
- **Decisiones:** sensor de suelo capacitivo (ADC), AHT20 + OLED compartiendo I2C1 (justifica `mtxI2C`), bomba con TIP120 y fuente 5 V aparte, 5 tareas / 5 prioridades, UART con dueño único (tLogger), tareas CubeMX "As weak" con implementación en `App/`.
- **Planta:** árbol de jade pequeño → umbrales de suculenta (seco 15 %, húmedo 35 %, pulsos de 1 s).
- **Pendiente:** Marco revisa la propuesta; comprar componentes (lunes); crear `.ioc` y proyecto base.
- **Problemas:** —

---

## Pendiente de Marco
Decisiones que el agente no tomó solo (2026-11-09). Nada de esto bloquea la integración.

1. **Fallo del SHT30 → ¿alarma o solo aviso?** [[arquitectura]] §4 lo deja en "decidir". tSensors ya envía `FAULT_AIR`; falta acordar con Estevan si tControl pasa a ALARMA o sigue regando sin dato de aire.
2. **Lectura del ADC por sondeo.** Son ≈ 0,2 ms de espera activa por lectura cada 500 ms. Si prefieres que no haya ni una sola espera activa que explicar ante la rúbrica, la alternativa es ADC en modo scan + DMA con notificación desde el callback, pero exige cambios en el `.ioc` (Estevan).
3. **Antirrebote del sensor de suelo.** `SOIL_FAULT_COUNT = 1` (alarma al primer ciclo con el sensor desconectado, como dice §4). Subirlo a 2–3 si en las pruebas aparecen falsas alarmas.
4. **Pantallas.** Revisa en la OLED real si te gustan las 3 pantallas y los textos (`task_display.c`); la orientación se cambia con `SSD1306_ROTATE_180`, y si el módulo resulta ser SH1106, `SSD1306_COL_OFFSET = 2`.
5. **Compilador en este PC.** El agente intentó instalar uno en una carpeta temporal para revisar la sintaxis y el permiso fue denegado. Si instalas STM32CubeIDE aquí, puede compilar en cuanto llegue el proyecto base.
6. **(2026-11-10) Resistencias de 220 Ω.** Hacen falta cuatro (tres del LED RGB y una del LED de riego) y la lista reducida compra dos: confirmar que ya hay otras dos.
7. ~~**(2026-11-10) Precio de los jumpers.**~~ Resuelto: la compra completa costó $59.160.
