GildardoRestrepo/greenhouse_Mata_freeRTOS/firmware/brote/brote.ioc

Mcu.UserName=STM32F407VETx
PA0-WKUP.GPIO_Label=BTN_KUP
PA0-WKUP.Signal=GPXTI0
PA10.Signal=USART1_RX
PA13.Signal=SYS_JTMS-SWDIO
PA14.Signal=SYS_JTCK-SWCLK
PA6.Signal=GPIO_Output
PA7.Signal=GPIO_Output
PA9.Signal=USART1_TX
PB6.Signal=I2C1_SCL
PB7.Signal=I2C1_SDA
PC0.Signal=ADCx_IN10
PC1.Signal=ADCx_IN11
PC6.GPIO_Label=PUMP_LED
PC6.Signal=GPIO_Output
PC7.GPIO_Label=BUZZER
PC7.Signal=GPIO_Output
PD12.Signal=S_TIM4_CH1
PD13.Signal=S_TIM4_CH2
PD14.Signal=S_TIM4_CH3
PE10.Signal=GPIO_Output
PE11.Signal=GPIO_Output
PE3.GPIO_Label=BTN_K1
PE3.Signal=GPXTI3
PE4.GPIO_Label=BTN_K0
PE4.Signal=GPXTI4
PE7.Signal=GPIO_Output
PE8.Signal=GPIO_Output
PE9.Signal=GPIO_Output
PH0-OSC_IN.Signal=RCC_OSC_IN
PH1-OSC_OUT.Signal=RCC_OSC_OUT
