GildardoRestrepo/greenhouse_Mata_freeRTOS/firmware/brote/Core/Inc/main.h

#define BTN_K1_Pin GPIO_PIN_3
#define BTN_K1_GPIO_Port GPIOE
#define BTN_K1_EXTI_IRQn EXTI3_IRQn
#define BTN_K0_Pin GPIO_PIN_4
#define BTN_K0_GPIO_Port GPIOE
#define BTN_K0_EXTI_IRQn EXTI4_IRQn
#define BTN_KUP_Pin GPIO_PIN_0
#define BTN_KUP_GPIO_Port GPIOA
#define BTN_KUP_EXTI_IRQn EXTI0_IRQn
#define PUMP_LED_Pin GPIO_PIN_6
#define PUMP_LED_GPIO_Port GPIOC
#define BUZZER_Pin GPIO_PIN_7
#define BUZZER_GPIO_Port GPIOC
