GildardoRestrepo/greenhouse_Mata_freeRTOS/(commit log)

2026-11-09 docs: propuesta, arquitectura y reglas compartidas para agentes
    - Propuesta "Brote" (mini-invernadero con árbol de jade): compras, pines, montaje, cronograma
    - Arquitectura FreeRTOS: 5 tareas, 5 prioridades, colas, notificaciones y mutex
    - CLAUDE.md y .claude/settings.json como contrato entre los agentes del equipo
    - Bitácora y plan de pruebas
2026-11-09 bom de componentes - pendientes algunas decisiones
2026-11-10 feat(app): tipos, configuración y snapshot compartidos
    INTERFAZ: app_types.h (arquitectura §3 + snapshot_t, fault_code_t y bits de
    valid_mask), app_config.h (valores Demo de §4) y app_shared.* (shared_get/set).
2026-11-10 feat(sht30): driver con medida 0x2400, CRC-8 y punto fijo
    Suelta mtxI2C durante los 20 ms de conversión (arquitectura §6).
2026-11-10 feat(display): fuente ASCII 5x7 en celda de 6x8
2026-11-10 feat(ssd1306): driver OLED con framebuffer estático, texto y barras
    Envío por páginas soltando mtxI2C entre una y otra.
2026-11-10 feat(sensors): tarea tSensors cada 500 ms con SHT30 cada 4 ciclos
    Envía EV_READING en cada ciclo y EV_SENSOR_FAULT al confirmarse un fallo.
2026-11-10 feat(display): tarea tDisplay cada 250 ms con tres pantallas y alarma
    Lee g_snapshot con shared_get() y reintenta el init si la OLED se pierde.
2026-11-10 docs: pruebas observables P13-P25 de drivers y tareas de Marco
2026-11-10 docs: bitácora de la sesión y contrato de snapshot y fallos (INTERFAZ)
2026-11-10 docs: entrada de bitácora de la sesión y lista Pendiente de Marco
2026-11-10 docs: BOM reducido con sensor YL-38/YL-69 y LED en lugar de la bomba
    INTERFAZ: PC6 pasa a manejar un LED indicador (bomba simulada) y el sensor
    de suelo es resistivo. Actualiza bom, propuesta, arquitectura, pruebas y
    bitácora.
2026-11-10 docs: ajustar en CLAUDE.md la regla de cargas a la bomba simulada
2026-11-10 feat(sensors): reemplazar el driver SHT30 por HTU21 (GY-21)
    INTERFAZ: drv_sht30 pasa a drv_htu21 (prefijo htu21_), con lecturas separadas
    de temperatura (0xF3) y humedad (0xF5) en 0x40, CRC-8 con init 0x00 y las
    fórmulas del HTU21. tSensors hace las dos lecturas en el ciclo del aire.
2026-11-10 docs: cambiar SHT30 por HTU21 en propuesta, arquitectura, BOM y pruebas
2026-11-10 docs: nombrar el HTU21 en las reglas y la tabla de módulos de CLAUDE.md
2026-11-10 docs: anotar el total pagado de la compra (59.160 COP)
2026-11-11 feat(control): logger, máquina de estados, tControl y tActuators
    - task_logger: log_printf no bloqueante sobre qLog y envío por DMA con
    thread flag desde HAL_UART_TxCpltCallback.
    - state_machine: lógica pura (sin HAL/RTOS) de INIT, MONITOREO, RIEGO,
    MANUAL y ALARMA.
    - task_control: consume qEvents, publica g_snapshot, detecta timeout de
    sensores; callback EXTI de botones con antirrebote.
    - task_actuators + drv_outputs: pulso de riego con tiempo máximo propio,
    buzzer y LED RGB por estado.
    - INTERFAZ: pila de tActuators 128 -> 256; constantes nuevas en
    app_config.h. Pruebas P26-P33 y bitácora.
    [app_config.h, drv_outputs.c, drv_outputs.h, state_machine.c, state_machine.h, task_actuators.c, task_actuators.h, task_control.c]
2026-11-11 cubemx: proyecto base con 5 tareas, colas, mutex y periféricos
    Generado con STM32CubeMX: reloj 168 MHz por HSE, SWD, TIM6 como timebase,
    ADC1 (PC0/PC1), I2C1 400 kHz, TIM4 PWM CH1-3, USART1 115200 + DMA2 Stream7,
    GPIO y EXTI de botones con prioridad 6. FreeRTOS CMSIS-V2: tActuators,
    tControl, tSensors, tDisplay, tLogger (As weak), qEvents, qLog, mtxI2C,
    mtxData, heap 32 KB, chequeo de pila opción 2.
    Además (fuera de lo generado): App/ añadida a includes y fuentes en
    .cproject; en freertos.c, dentro de USER CODE, los includes de tipos de
    las colas y la llamada a act_fatal_stack_overflow() en el hook de pila.
2026-11-11 fix(sensors): enviar EV_READING antes de medir el HTU21
    La medida del aire (≈ 75 ms) retrasaba el evento uno de cada cuatro ciclos.
    Ahora el evento sale al despertar y el dato del aire viaja en el siguiente.
    [task_sensors.c]
2026-11-11 docs: diagrama y lista de cableado a partir de la tabla de pines
2026-11-11 docs: P19, contrato de tSensors y bitácora tras el arreglo del evento
2026-11-11 fix(core): añadir TIM6_DAC_IRQHandler para la base de tiempo de la HAL
    CubeMX 6.18.1 no generó la interrupción de TIM6 aunque SYS usa TIM6 como
    timebase: HAL_Init() la habilita y el primer tick caía en Default_Handler
    (GDB lo mostraba como WWDG_IRQHandler en main.c:81). Se define en
    USER CODE BEGIN 1 de stm32f4xx_it.c para que sobreviva a regenerar.
2026-11-11 fix(analog): calibrar suelo y LDR con valores medidos
    Suelo: aire = 3604, agua = 1187. LDR: tapada = 987, linterna = 3531.
    Medidos en la placa con el depurador (P03, P16, P17).
    [app_config.h]
2026-11-11 fix(outputs): buzzer activo en alto
    INTERFAZ: el módulo comprado es de disparo en alto (suena con la señal
    a 3V3 y se calla con GND). out_buzzer() pasa a sonar con GPIO_PIN_SET.
    Se corrige la documentación que lo describía como activo en bajo.
    [drv_outputs.c, drv_outputs.h]
2026-11-11 docs: resultados de calibración y riego, bitácora del 2026-11-11
2026-11-11 docs: alinear la documentación con el código y la placa
    Buzzer activo en alto en arquitectura, hook de pila, fallo de aire,
    evidencia de preempción sin analizador, bases de tiempo, checklist de
    CubeMX (TIM6_DAC_IRQHandler, NVIC, ruta del proyecto), P04 y P10,
    USB-TTL pendiente en el BOM, README con BOM, cableado y estado.
2026-11-11 docs: reorganizar el README para GitHub
    Título con el nombre del proyecto, fotos, tablas de tareas, estados y
    pines, pasos para compilar y cargar, uso de los botones y enlaces
    Markdown normales en lugar de enlaces de Obsidian.
